DCelectronics/Pico-DVI-Sock/Pico-DVI-Sock-v5.1.9/img/dvi_pico_sock_front.png

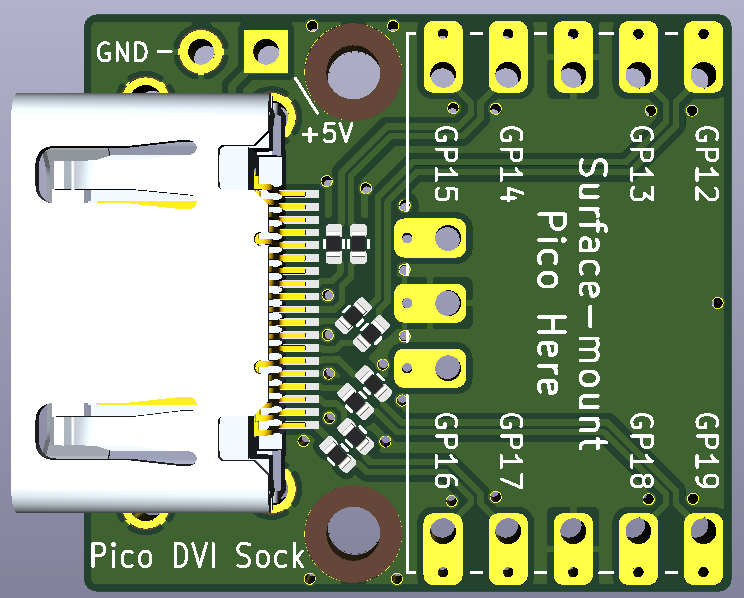
Pico-DVI-Sock-v5.1.9/img/dvi_pico_sock_front.png
