DCelectronics/Pico-DVI-Sock/Pico-DVI-Sock-v5.1.9/dvi-sock_v5.1.9.pdf

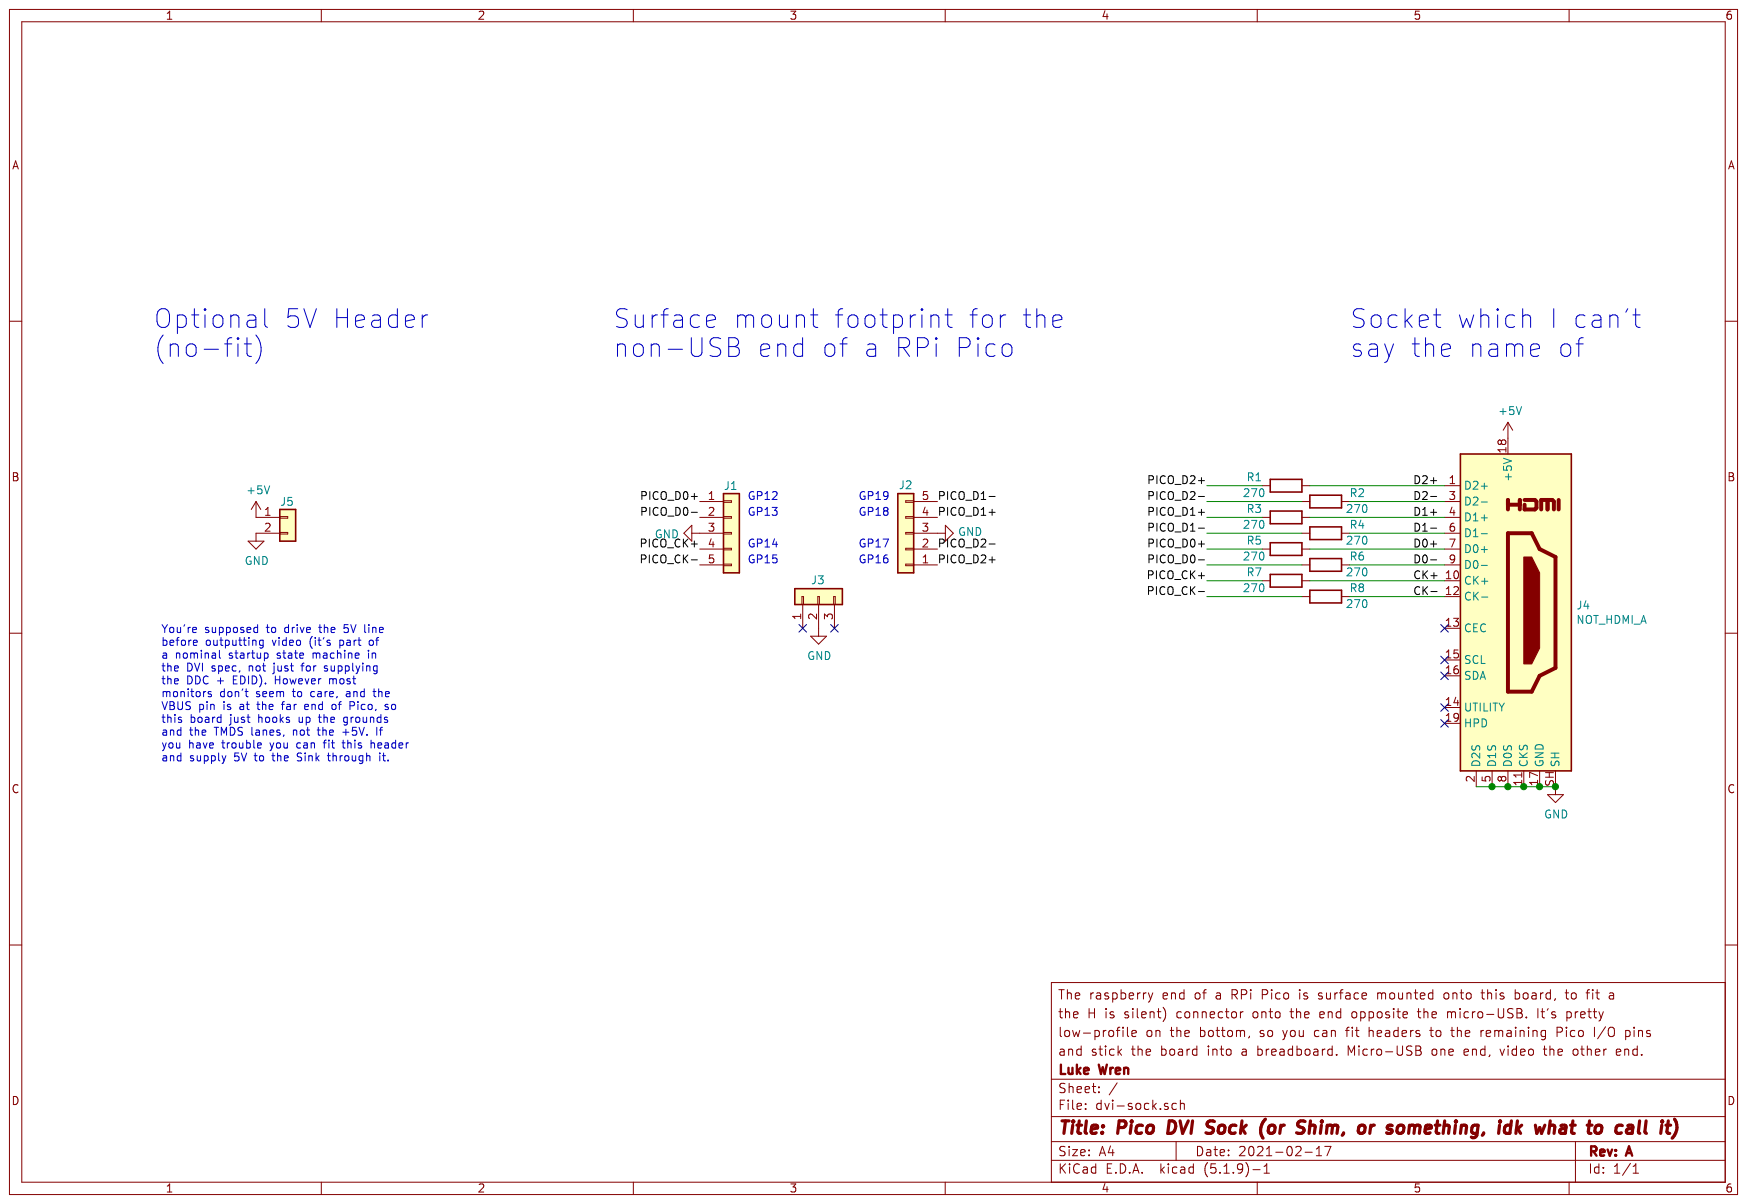
[picture p3: page 1]
