DCelectronics/Pico-DVI-Sock/Pico-DVI-Sock-v5.1.9/dvi-sock.kicad_pcb

## KiCad design Pico-DVI-Sock-v5.1.9/dvi-sock.kicad_pcb (2021-02-18)

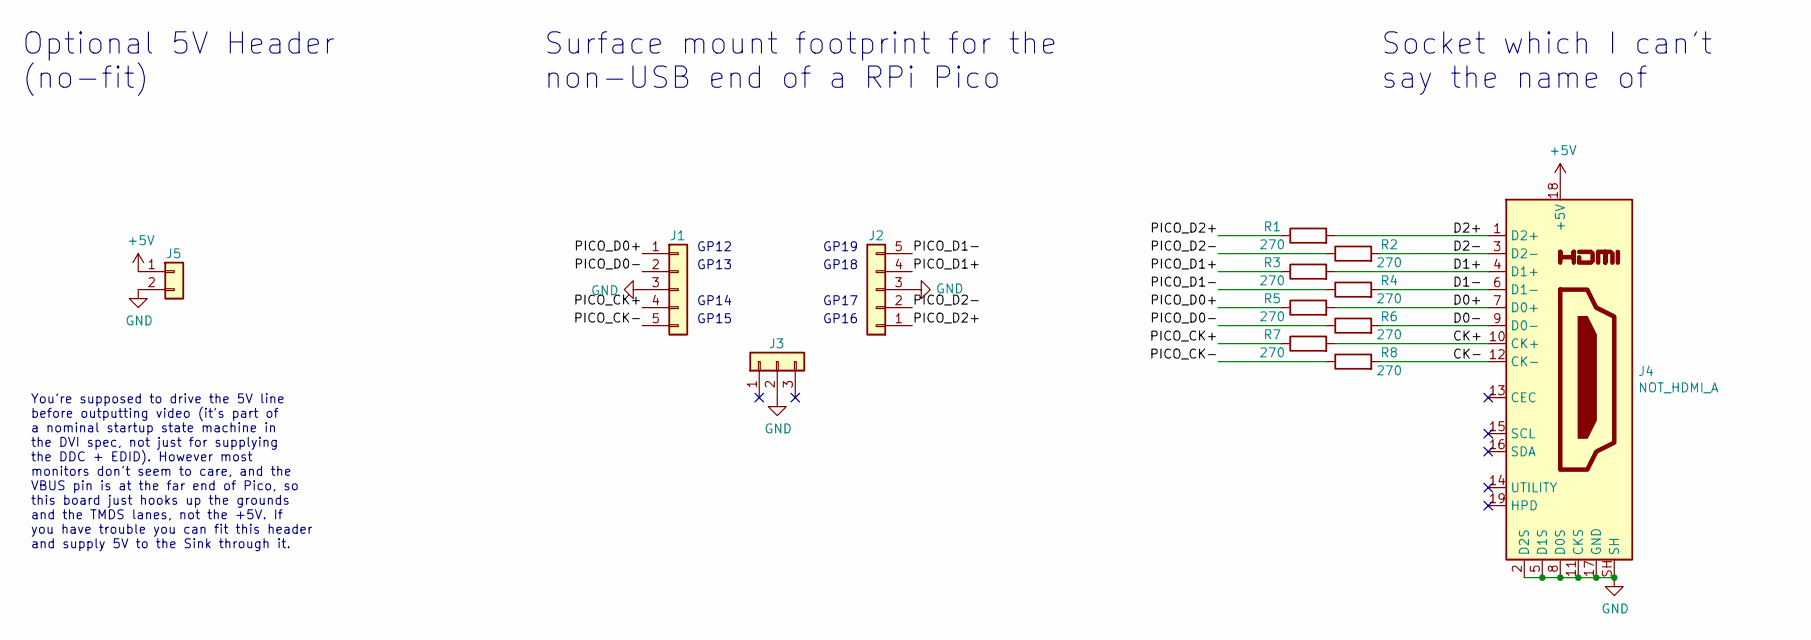
[picture p4: schematic dvi-sock.sch, Pico DVI Sock (or Shim, or something, idk what to call it)]

Parts:
J1, J2: Conn_01x05; castellated_2.54mm_smd_x5
J3: Conn_01x03; castellated_2.54mm_smd_x3
J4: NOT_HDMI_A; HDMI-SS-53000
J5: Conn_01x02; PinHeader_1x02_P2.54mm_Vertical_nosilk
R1, R2, R3, R4, R5, R6, R7, R8: 270; R_0402_1005Metric

Connections:
+5V: J4.18 (+5V), J5.1
/CK+: J4.10 (CK+), R7.2
/CK-: J4.12 (CK-), R8.2
/D0+: J4.7 (D0+), R5.2
/D0-: J4.9 (D0-), R6.2
/D1+: J4.4 (D1+), R3.2
/D1-: J4.6 (D1-), R4.2
/D2+: J4.1 (D2+), R1.2
/D2-: J4.3 (D2-), R2.2
/PICO_CK+: J1.4, R7.1
/PICO_CK-: J1.5, R8.1
/PICO_D0+: J1.1, R5.1
/PICO_D0-: J1.2, R6.1
/PICO_D1+: J2.4, R3.1
/PICO_D1-: J2.5, R4.1
/PICO_D2+: J2.1, R1.1
/PICO_D2-: J2.2, R2.1
GND: J1.3, J2.3, J3.2, J4.2 (D2S), J4.5 (D1S), J4.8 (D0S), J4.11 (CKS), J4.17 (GND), J4.SH, J5.2

Notes on the sheet:
Optional 5V Header (no-fit)
You're supposed to drive the 5V line before outputting video (it's part of a nominal startup state machine in the DVI spec, not just for supplying the DDC + EDID). However most monitors don't seem to care, and the VBUS pin is at the far end of Pico, so this board just hooks up the grounds and the T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
Surface mount footprint for the non-USB end of a RPi Pico
Socket which I can't say the name of
GP12
GP13
GP14
GP15
GP19
GP18
GP17
GP16

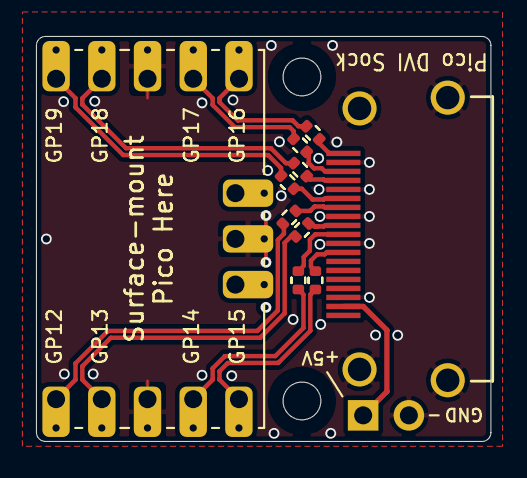
[picture p5: board dvi-sock.kicad_pcb from above]

Board: 2 copper layers, 25.2 x 22.5 mm, 13 parts (0 on the bottom side), 18 nets.
